mattrude/radio-clock-rebuild/README.md

# Radio Clock Rebuild

This is a rebuild of the ES100 Radio Clock development board.
