mattrude/radio-clock-rebuild/Hardware/Radio clock rebuild.kicad_sch

## KiCad design Hardware/Radio clock rebuild.kicad_sch (2025-03-13)

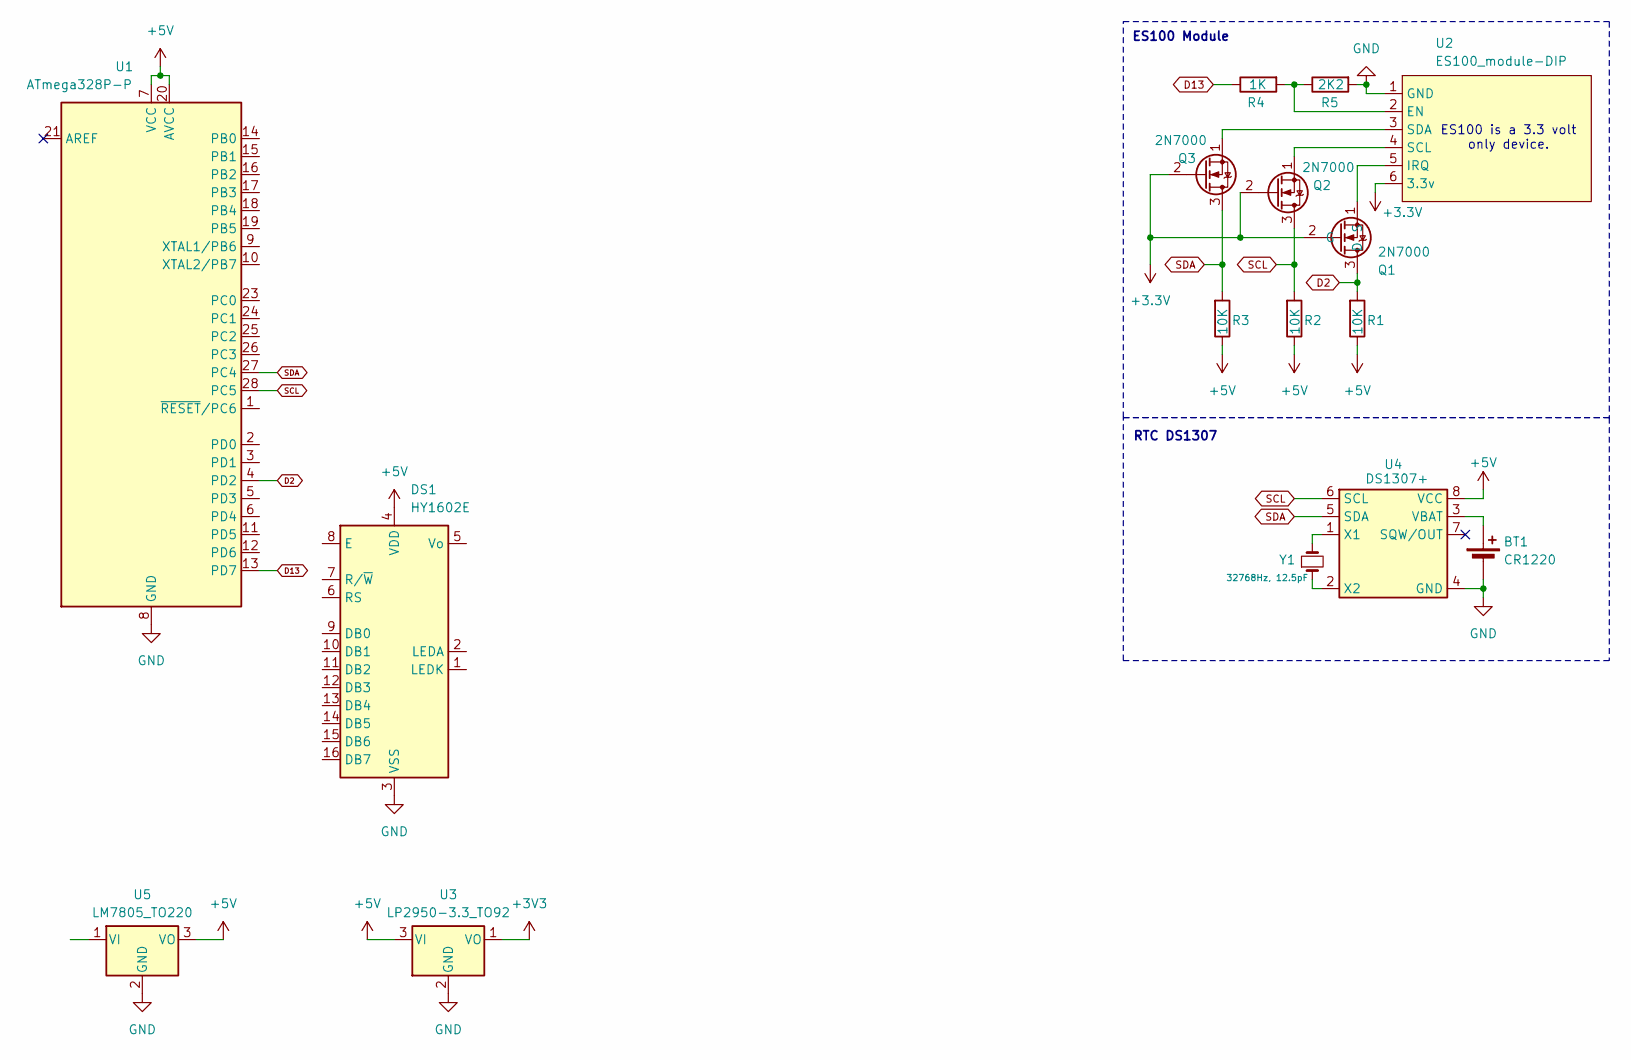
[picture p7: schematic Radio clock rebuild.kicad_sch]

Parts:
BT1: CR1220
DS1: HY1602E
Q1, Q2, Q3: 2N7000; TO-92_Inline
R1, R2, R3: 10K
R4: 1K
R5: 2K2
U1: ATmega328P-P; DIP-28_W7.62mm
U2: ES100_module-DIP; ES100-DIP
U3: LP2950-3.3_TO92; TO-92_Inline
U4: DS1307+; DIP-8_W7.62mm
U5: LM7805_TO220; TO-220-3_Vertical
Y1: 32768Hz, 12.5pF

Connections:
+3.3V: Q1.2 (G), Q2.2 (G), Q3.2 (G), U2.6 (3.3v)
+3V3: U3.1 (VO)
+5V: DS1.4 (VDD), R1.1, R2.1, R3.1, U1.7 (VCC), U1.20 (AVCC), U3.3 (VI), U4.8 (VCC), U5.3 (VO)
D2: Q1.3 (D), R1.2, U1.4 (PD2)
D13: R4.1, U1.13 (PD7)
GND: BT1.2 (-), DS1.3 (VSS), R5.2, U1.8 (GND), U1.22 (GND), U2.1 (GND), U3.2 (GND), U4.4 (GND), U5.2 (GND)
unnamed: BT1.1 (+), U4.3 (VBAT)
unnamed: Q1.1 (S), U2.5 (IRQ)
unnamed: Q2.1 (S), U2.4 (SCL)
unnamed: Q3.1 (S), U2.3 (SDA)
unnamed: R4.2, R5.1, U2.2 (EN)
unnamed: U4.1 (X1), Y1.2
unnamed: U4.2 (X2), Y1.1
SCL: Q2.3 (D), R2.2, U1.28 (PC5), U4.6 (SCL)
SDA: Q3.3 (D), R3.2, U1.27 (PC4), U4.5 (SDA)

Notes on the sheet:
RTC DS1307
ES100 is a 3.3 volt only device.
ES100 Module
