mattrude/radio-clock-rebuild/Software/src/main.cpp

/*
 * This is the demonstration code for the UNIVERSAL-SOLDER / Everset ES100 
 * Application Development Kit. It reads the decoded time stamp from 
 * the ES100MOD receiver module and shows several information on a 4x20
 * character display. There are no function assignments for unused GPIO,
 * analog inputs and the 3 push buttons included in this sketch.
 * 
 * Version: 1.3 (10/26/2022)
 *
 * https://universal-solder.ca/product/canaduino-application-development-kit
 * -with-everset-es100-mod-wwvb-bpsk-atomic-clock-receiver-module/
 * 
 * NEW in 1.2: I2C bus clock speed reduced to 100kHz for better compatibility
 * with different RTC chips. The following libraries are required:
 * - DS1307RTC by Paul Stoffregen (tested with version 1.4.1)
 * - Time by Michael Margolis (tested with version 1.6.1)
 * - ES100 by UNIVERSAL-SOLDER (version 1.1 required)
 * - LiquidCrystal (Arduino standard)
 * - Wire (Arduino standard)
 * 
 * PLEASE FEEL FREE TO CONTRIBUTE TO THE DEVELOPMENT. CORRECTIONS AND
 * ADDITIONS ARE HIGHLY APPRECIATED. SEND YOUR COMMENTS OR CODE TO:
 * support@universal-solder.com 
 * 
 * Please support us by purchasing products from UNIVERSAL-SOLDER.com store!
 * 
 * Copyright (c) 2022 UNIVERSAL-SOLDER Electronics Ltd. All rights reserved.
 * 
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
 * THIS SOFTWARE IS PROVIDED BY THE COPYRIGHT HOLDERS AND CONTRIBUTORS "AS IS"
 * AND ANY EXPRESS OR IMPLIED WARRANTIES, INCLUDING, BUT NOT LIMITED TO, THE
 * IMPLIED WARRANTIES OF MERCHANTABILITY AND FITNESS FOR A PARTICULAR PURPOSE
 * ARE DISCLAIMED. IN NO EVENT SHALL THE COPYRIGHT HOLDER OR CONTRIBUTORS BE
 * LIABLE FOR ANY DIRECT, INDIRECT, INCIDENTAL, SPECIAL, EXEMPLARY, OR
 * CONSEQUENTIAL DAMAGES (INCLUDING, BUT NOT LIMITED TO, PROCUREMENT OF
 * SUBSTITUTE GOODS OR SERVICES; LOSS OF USE, DATA, OR PROFITS; OR BUSINESS
 * INTERRUPTION) HOWEVER CAUSED AND ON ANY THEORY OF LIABILITY, WHETHER IN
 * CONTRACT, STRICT LIABILITY, OR TORT (INCLUDING NEGLIGENCE OR OTHERWISE)
 * ARISING IN ANY WAY OUT OF THE USE OF THIS SOFTWARE, EVEN IF ADVISED OF THE
 * POSSIBILITY OF SUCH DAMAGE.
 */

//////////////////////////////////////////////////////////////////////////////

/*  Time zone and DST setting:
 *  The value for es100.timezone can be positive or negative
 *  For example: es100.timezone = -6
 * 
 *  The value for es100.DSTenable can be true or false
 *  For example: es100.DSTenabled = true
 * 
 *  If es100.DSTenabled is false, then no DST correction is performed
 *  even if DST is in effect.
 */
signed int timeZone = -6;
bool daylightSavings = true;

// include the library code:
#include <Arduino.h>
#include <Wire.h>
#include <LiquidCrystal.h>
#include <DS1307RTC.h>
#include <EEPROM.h>
#include <ES100.h>

#define lcdRS 4  // D4: Pin 6 on ATmega328P
#define lcdEN 5  // D5: Pin 11 on ATmega328P
#define lcdD4 8  // D8: Pin 14 on ATmega328P
#define lcdD5 9  // D9: Pin 15 on ATmega328P
#define lcdD6 10 // D10: in 16 on ATmega328P
#define lcdD7 11 // D11: in 17 on ATmega328P
LiquidCrystal lcd(lcdRS, lcdEN, lcdD4, lcdD5, lcdD6, lcdD7);

#define es100Int 2 // D2: Pin 4 on ATmega328P
#define es100En 13 // D13: Pin 19 on ATmega328P

ES100 es100;

uint8_t lp = 0;

unsigned long lastMillis = 0;
volatile unsigned long atomicMillis = 0;
unsigned long lastSyncMillis = 0;

volatile unsigned int interruptCnt = 0;
unsigned int lastinterruptCnt = 0;

bool DSTeeprom;
int TZeeprom;

boolean receiving = false;    // variable to determine if we are in receiving mode
boolean trigger = true;       // variable to trigger the reception
boolean continous = true;     // variable to tell the system to continously receive atomic time, if not it will happen every night at midnight
boolean validdecode = false;  // variable to rapidly know if the system had a valid decode done lately

ES100DateTime d;
ES100Status0 status0;
ES100NextDst nextDst;

void sectionBrake() {
  Serial.println("");
  Serial.println("---------------------------------------------------");
  Serial.println("");
}

void atomic() {
    // Called procedure when we receive an interrupt from the ES100
    // Got a interrupt and store the currect millis for future use
    // if we have a valid decode
    atomicMillis = millis();
    interruptCnt++;
}

char* getISODateStr() {
  static char result[19];

  tmElements_t t;
  RTC.read(t);  //TODO:

  result[0] = char(((t.Year + 1970) / 1000) + 48);
  result[1] = char((((t.Year + 1970) % 1000) / 100) + 48);
  result[2] = char((((t.Year + 1970) % 100) / 10) + 48);
  result[3] = char(((t.Year + 1970) % 10) + 48);
  result[4] = 45;

  if (t.Month < 10) {
    result[5] = 48;
  } else {
    result[5] = char((t.Month / 10) + 48);
  }
  
  result[6] = char((t.Month % 10) + 48);
  result[7] = 45;
  
  if (t.Day < 10) {
    result[8] = 48;
  } else {
    result[8] = char((t.Day / 10) + 48);
  }

  result[9] = char((t.Day % 10) + 48);
  result[10] = 84;

  if (t.Hour < 10) {
    result[11] = 48;
  } else {
    result[11] = char((t.Hour / 10) + 48);
  }

  result[12] = char((t.Hour % 10) + 48);
  result[13] = 58;
  
  if (t.Minute < 10) {
    result[14] = 48;
  } else {
    result[14] = char((t.Minute / 10) + 48);
  }
  
  result[15] = char((t.Minute % 10) + 48);
  result[16] = 58;

  if (t.Second < 10) {
    result[17] = 48;
  } else {
    result[17] = char((t.Second / 10) + 48);
  }

  result[18] = char((t.Second % 10) + 48);
  result[19] = 90;
  result[20] = 0;

  return result;
}

// Prints to LCD if DST is in Effect or not
void displayDST() {
  lcd.print("DST ");
  switch (status0.dstState) {
    case B00:
      lcd.print("is Not In Effect");
      break;
    case B10:
      lcd.print("Begins Today");
      break;
    case B11:
      lcd.print("is In Effect");
      break;
    case B01:
      lcd.print("Ends Today");
      break;
  }
}

// Prints to LCD the Next DST Date of change
void displayNDST() {
  byte tmp = 0;
  lcd.print("NDST ");

  tmp = nextDst.month;
  if (tmp < 10) { lcd.print("0"); }
  lcd.print(tmp);
  lcd.print("/");

  tmp = nextDst.day;
  if (tmp < 10) { lcd.print("0"); }
  lcd.print(tmp);
  lcd.print(" ");

  tmp = nextDst.hour;
  if (tmp < 10) { lcd.print("0"); }
  lcd.print(tmp);
  lcd.print(":00");
}

// Prints to LCD if this month has a leep second
void displayLeapSecond() {
  switch (status0.leapSecond) {
    case B00:
      lcd.print("No LS this month");
      break;
    case B10:
      lcd.print("Neg. LS this month");
      break;
    case B11:
      lcd.print("Pos. LS this month");
      break;
  }
}

// Prints to LCD when the last time sync was (the date/time of it)
void displayLastSync() {
  lcd.print("Last sync ");

  if (lastSyncMillis > 0) {
    int days = (millis() - lastSyncMillis) / 86400000;
    int hours = ((millis() - lastSyncMillis) % 86400000) / 3600000;
    int minutes = (((millis() - lastSyncMillis) % 86400000) % 3600000) / 60000;
    int seconds = ((((millis() - lastSyncMillis) % 86400000) % 3600000) % 60000) / 1000;

    if (days > 0) {
      if (days < 10) { lcd.print("0"); }
      lcd.print(days);
      lcd.print("d");
      if (hours < 10) { lcd.print("0"); }
      lcd.print(hours);
      lcd.print("h");
      if (minutes < 10) { lcd.print("0"); }
      lcd.print(minutes);
      lcd.print("m");
    } else {
      if (hours > 0) {
        if (hours < 10) { lcd.print("0"); }
        lcd.print(hours);
        lcd.print("h");
        if (minutes < 10) { lcd.print("0"); }
        lcd.print(minutes);
        lcd.print("m");
        if (seconds < 10) { lcd.print("0"); }
        lcd.print(seconds);
        lcd.print("s");
      } else {
        if (minutes > 0) {
          if (minutes < 10) { lcd.print("0"); }
          lcd.print(minutes);
          lcd.print("m");
          if (seconds < 10) { lcd.print("0"); }
          lcd.print(seconds);
          lcd.print("s");
        } else {
          if (seconds < 10) { lcd.print("0"); }
          lcd.print(seconds);
          lcd.print("s");
        }
      }
    }
  } else {
    lcd.print("never");
  }
}

// Prints to LCD the current interrupt count
void displayInterrupt() {
  lcd.print("Interrupt Count ");
  lcd.print(interruptCnt);
}

// Prints to LCD the currnt Time Zone
void displayTimeZone() {
  lcd.print("Time Zone ");
  if ( timeZone == -5 ) {
    lcd.print("EST");
  } else if (timeZone == -6) {
    lcd.print("CST");
  } else if (timeZone == -7) {
    lcd.print("MST");
  } else if (timeZone == -8) {
    lcd.print("PST");
  } else {
    lcd.print("Unknown");
  }
}

void displayDaylightSavies() {
  if (daylightSavings == true) {
    lcd.print("Subscribed to DST");
  } else{
    lcd.print("Unsubscribed to DST");
  }
}

void displayAntenna() {
  lcd.print("Antenna used ");
  switch (status0.antenna) {
    case B0:
      lcd.print("1");
      break;
    case B1:
      lcd.print("2");
      break;
  }
}

void clearLine(unsigned int n) {
  while (n-- > 0)
    lcd.print(" ");
}

void showlcd() {
  lcd.setCursor(0, 0);
  lcd.print(getISODateStr());

  if (validdecode) {
    // Scroll lines every 2 seconds.
    int lcdLine = (millis() / 2000 % 6) + 1;

    lcd.setCursor(0, 1);
    clearLine(20);
    lcd.setCursor(0, 1);
    switch (lcdLine) {
      case 1:
        displayInterrupt();
        break;
      case 2:
        displayLastSync();
        break;
      case 3:
        displayDST();
        break;
      case 4:
        displayNDST();
        break;
      case 5:
        displayLeapSecond();
        break;
      case 6:
        displayAntenna();
        break;
    }

    lcd.setCursor(0, 2);
    clearLine(20);
    lcd.setCursor(0, 2);
    switch (lcdLine) {
      case 6:
        displayInterrupt();
        break;
      case 1:
        displayLastSync();
        break;
      case 2:
        displayDST();
        break;
      case 3:
        displayNDST();
        break;
      case 4:
        displayLeapSecond();
        break;
      case 5:
        displayAntenna();
        break;
    }

    lcd.setCursor(0, 3);
    clearLine(20);
    lcd.setCursor(0, 3);
    switch (lcdLine) {
      case 5:
        displayInterrupt();
        break;
      case 6:
        displayLastSync();
        break;
      case 1:
        displayDST();
        break;
      case 2:
        displayNDST();
        break;
      case 3:
        displayLeapSecond();
        break;
      case 4:
        displayAntenna();
        break;
    }

  } else {
    lcd.setCursor(0, 1);
    displayInterrupt();
    lcd.setCursor(0, 2);
    displayTimeZone();
    lcd.setCursor(0, 3);
    displayDaylightSavies();
  }
  // ToDo:
  //   Show rolling status of the following informations :
  //   Interrupt Count xxxx  /* Where x = 0 to 9999 */
  //   Last sync xxxxxx ago  /* Where x = 59s / 59m59s / 23h59m / 49d23h */
  //   DST xxxxxxxxxxxxxxxx  /* Day Light Saving : Where x = is Not In Effect / Begins Today / is In Effect / Ends Today */
  //   NDST xxxxxxxxxxxxxxx  /* Next DST : Where x = 2019-11-03T2h00 */
  //   xxxxxxxxxxxxxxxxxxxx  /* Leap Second : Where x = No LS this month / Neg. LS this month / Pos. LS this month */
  //   Antenna used x    /* Antenna Used for reception where x = 1 or 2 */
}


/******************************************************************************
 * 
 */

void setup() {
  Wire.begin();

  DSTeeprom = EEPROM.read(01);
  TZeeprom = EEPROM.read(02);

  Serial.begin(9600);

  sectionBrake();

  Serial.println("ES100 Master Clock - Version 1.3");
  Serial.println("Matt Rude <matt@mattrude.com>");
  Serial.println("https://github.com/mattrude/radio-clock-rebuild");
  Serial.println("");

  Serial.print("RTC Time: ");
  Serial.println(getISODateStr());

  Serial.print("Time Zone ");
  if ( TZeeprom == 00 ) {
    Serial.println("EST");
    timeZone = -5;
  } else if (TZeeprom == 01) {
    Serial.println("CST");
    timeZone = -6;
  } else if (TZeeprom == 02) {
    Serial.println("MST");
    timeZone = -7;
  } else if (TZeeprom == 03) {
    Serial.println("PST");
    timeZone = -8;
  } else {
    Serial.println("Unknown; setting to CST");
    timeZone = -6;
    //EEPROM.write(02, 01);
  }

  if ( DSTeeprom == true) {
    Serial.println("Subscribed to DST");
    daylightSavings = true;
  } else if (DSTeeprom == false) {
    Serial.println("NOT Subscribed to DST");
    daylightSavings = false;
  } else {
    Serial.println("DST status unknown; setting to enabled");
    daylightSavings = true;
    //EEPROM.write(01, true);
  }

  sectionBrake();

  lcd.begin(20, 4);
  lcd.clear();
  lcd.setCursor(0, 1);
  lcd.print(" ES100 Master Clock");
  lcd.setCursor(0, 2);
  lcd.print("    Version 1.3");
  delay(2000);
  lcd.clear();

  es100.begin(es100Int, es100En);

  es100.timezone = timeZone;
  es100.DSTenabled = daylightSavings;

  attachInterrupt(digitalPinToInterrupt(es100Int), atomic, FALLING);
}

void loop() {
  tmElements_t tm;

  if (!receiving && trigger) {
    interruptCnt = 0;

    es100.enable();

    Serial.print("RTC Time: ");
    Serial.println(getISODateStr());

    es100.startRx();

    Serial.print("RTC Time: ");
    Serial.println(getISODateStr());

    receiving = true;
    trigger = false;

    /* Important to set the interrupt counter AFTER the startRx because the es100 
     * confirm that the rx has started by triggering the interrupt. 
     * We can't disable interrupts because the wire library will stop working
     * so we initialize the counters after we start so we can ignore the first false 
     * trigger
     */
    lastinterruptCnt = 0;
    interruptCnt = 0;
  }

  if (lastinterruptCnt < interruptCnt) {
    sectionBrake();
    Serial.print("RTC Time: ");
    Serial.println(getISODateStr());
    Serial.println("ES100 Interrupt received...");

    if (es100.getIRQStatus() == 0x01 && es100.getRxOk() == 0x01) {
      validdecode = true;
      Serial.println("Valid decode");

      // Update lastSyncMillis for lcd display
      lastSyncMillis = millis();

      // We received a valid decode
      d = es100.getDateTime();

      // Updating the RTC
      tm.Day = d.day;
      tm.Month = d.month;
      tm.Year = (30 + d.year);

      tm.Hour = d.hour;
      tm.Minute = d.minute;
      tm.Second = d.second + ((millis() - atomicMillis) / 1000);

      RTC.write(tm);  //TODO:

      Serial.println(tm.Day);
      Serial.println(tm.Month);
      Serial.println(tm.Year);

      Serial.println(tm.Hour);
      Serial.println(tm.Minute);
      Serial.println(tm.Second);

      // Get everything before disabling the chip.
      status0 = es100.getStatus0();
      nextDst = es100.getNextDst();

      /* DEBUG */
      Serial.print("status0.rxOk = B");
      Serial.println(status0.rxOk, BIN);
      Serial.print("status0.antenna = B");
      Serial.println(status0.antenna, BIN);
      Serial.print("status0.leapSecond = B");
      Serial.println(status0.leapSecond, BIN);
      Serial.print("status0.dstState = B");
      Serial.println(status0.dstState, BIN);
      Serial.print("status0.tracking = B");
      Serial.println(status0.tracking, BIN);
      /* END DENUG */

      if (!continous) {
        es100.stopRx();
        es100.disable();
        receiving = false;
      }
    } else {
      Serial.println("Invalid decode");
    }
    lastinterruptCnt = interruptCnt;
  }

  if (lastMillis + 100 < millis()) {
    showlcd();

    // set the trigger to start reception at midnight (UTC-4) if we are not in continous mode.
    // 4am UTC is midnight for me, adjust to your need
    //trigger = (!continous && !receiving && tm.Hour == 0 && tm.Minute == 0);
    trigger = (!continous && !receiving && tm.Minute == 0);

    lastMillis = millis();
  }
}
