mattrude/radio-clock-rebuild/(commit log)

2025-03-12 remove unused file
    [Radio clock rebuild.kicad_pcb]
2025-03-13 starting to flush out the hardware
    [Radio clock rebuild.kicad_sch]
